DhruvaD1/ECE445Notebook/notebooks/tnapier2/Devboard_layout.jpg

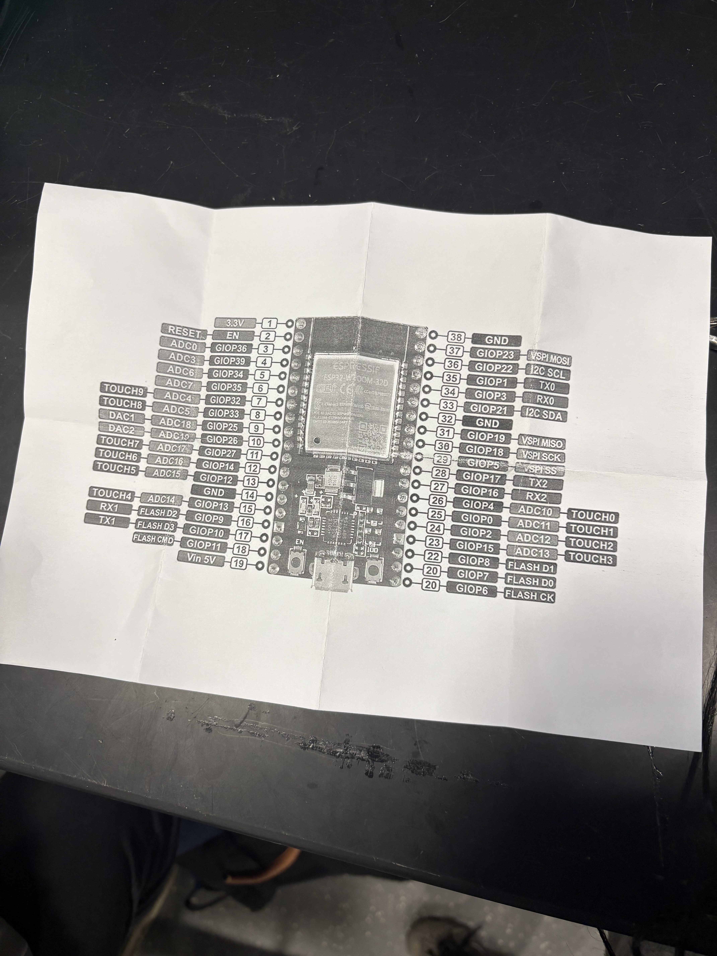
[picture p15: notebooks/tnapier2/Devboard_layout.jpg]
notebooks/tnapier2/Devboard_layout.jpg
